AtomicRoboticsX/Only/t-photos/Divertida.png

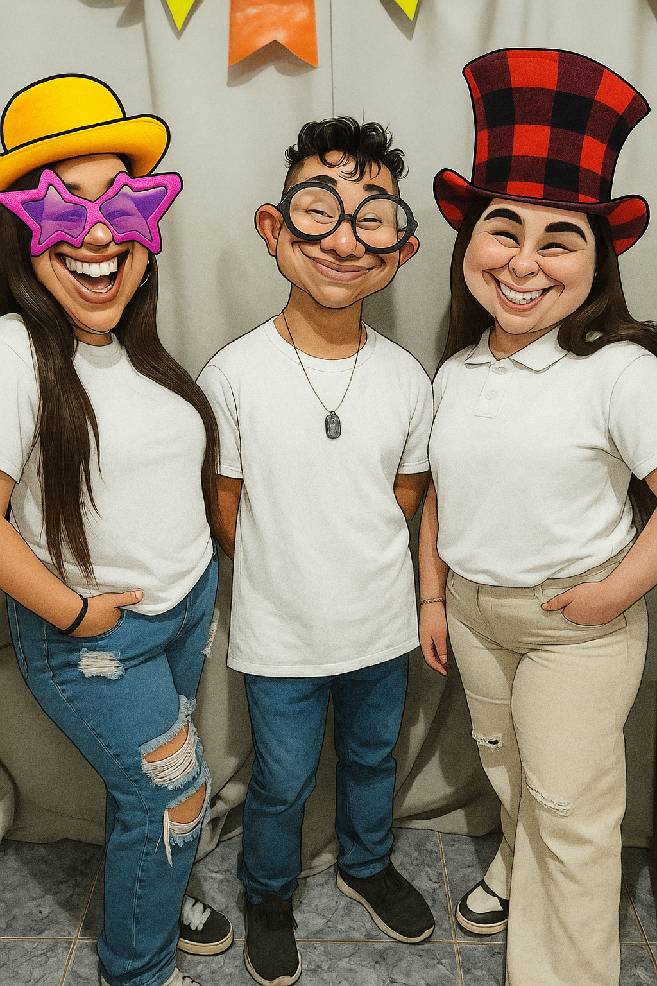
t-photos/Divertida.png
