AtomicRoboticsX/Only/schemes/CIRCUITO.png

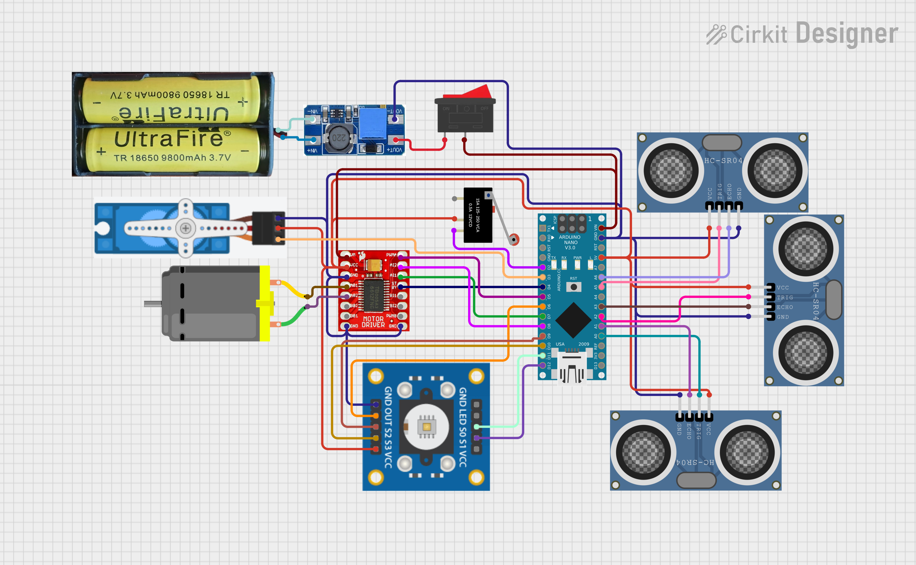
schemes/CIRCUITO.png
