AtomicRoboticsX/Only/video/video.md

/_video de prueba n°1_/
https://youtube.com/shorts/ghTwBgEqhd0?feature=share

/_video de prueba n°2_/
https://youtube.com/shorts/INSqkasOESc?feature=share
