AtomicRoboticsX/Only/t-photos/Oficial.jpeg

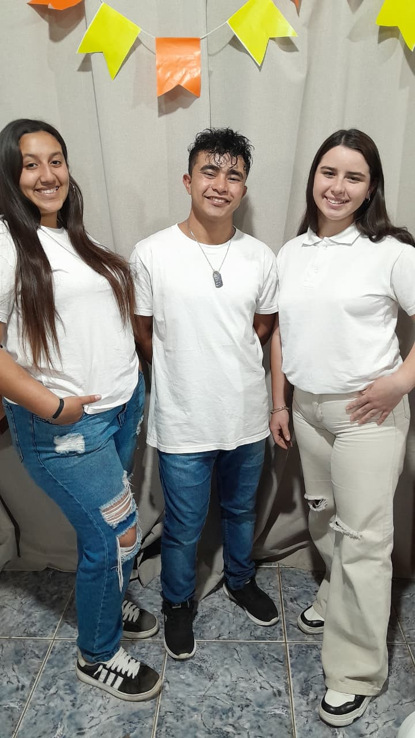
t-photos/Oficial.jpeg
