AtomicRoboticsX/Only/v-photos/ONLY (1).jpeg

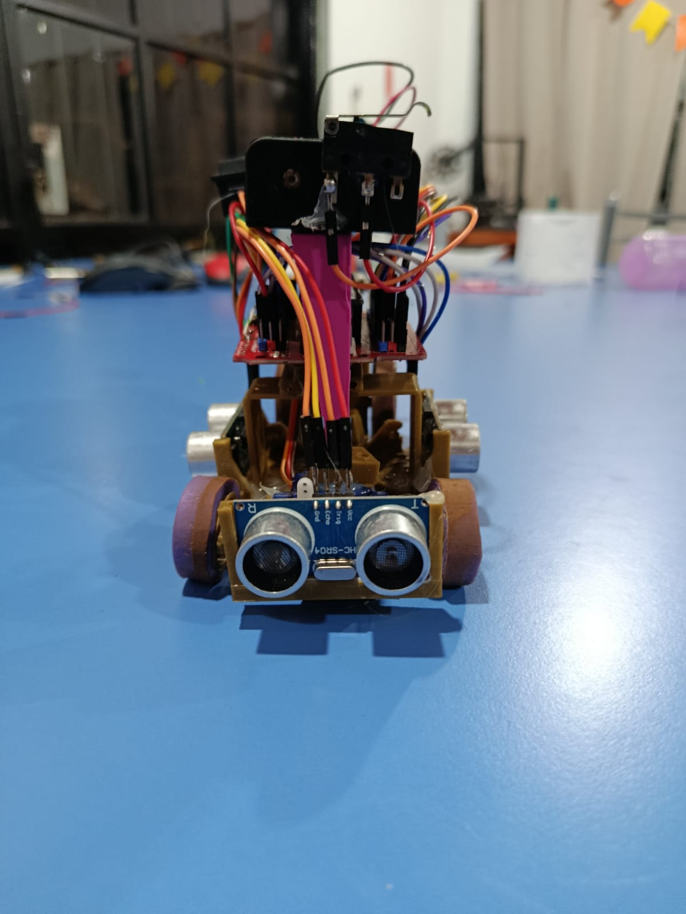
v-photos/ONLY (1).jpeg
