AtomicRoboticsX/Only/v-photos/ONLY (2).jpeg

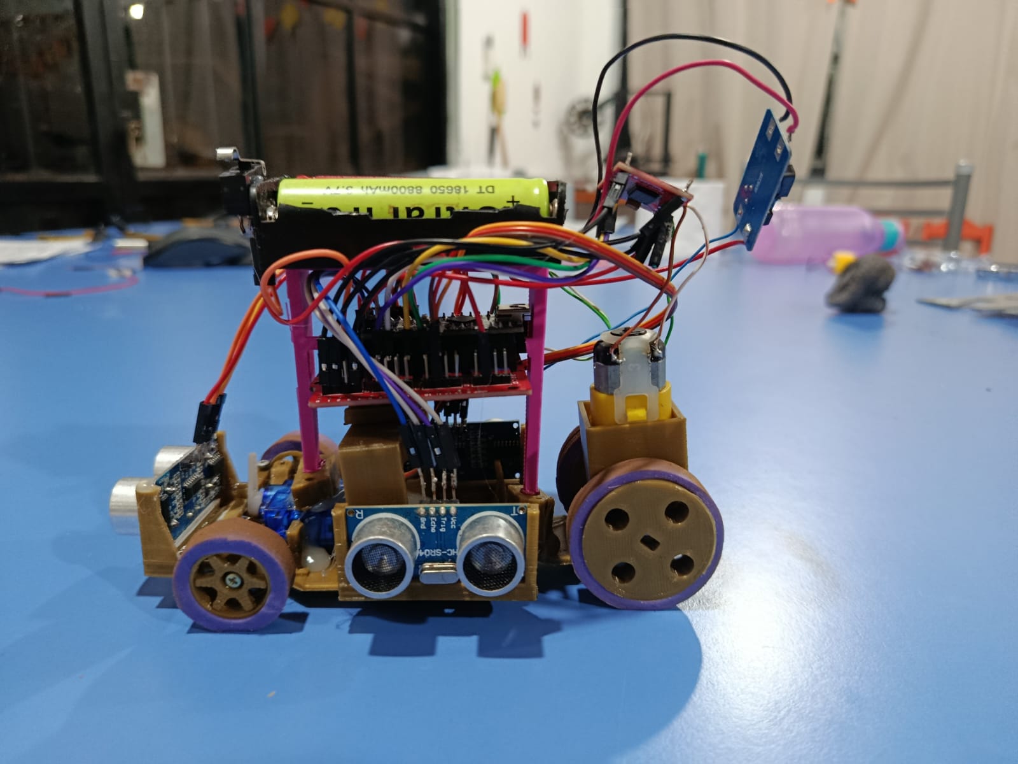
v-photos/ONLY (2).jpeg
