AtomicRoboticsX/Only/v-photos/ONLY (3).jpeg

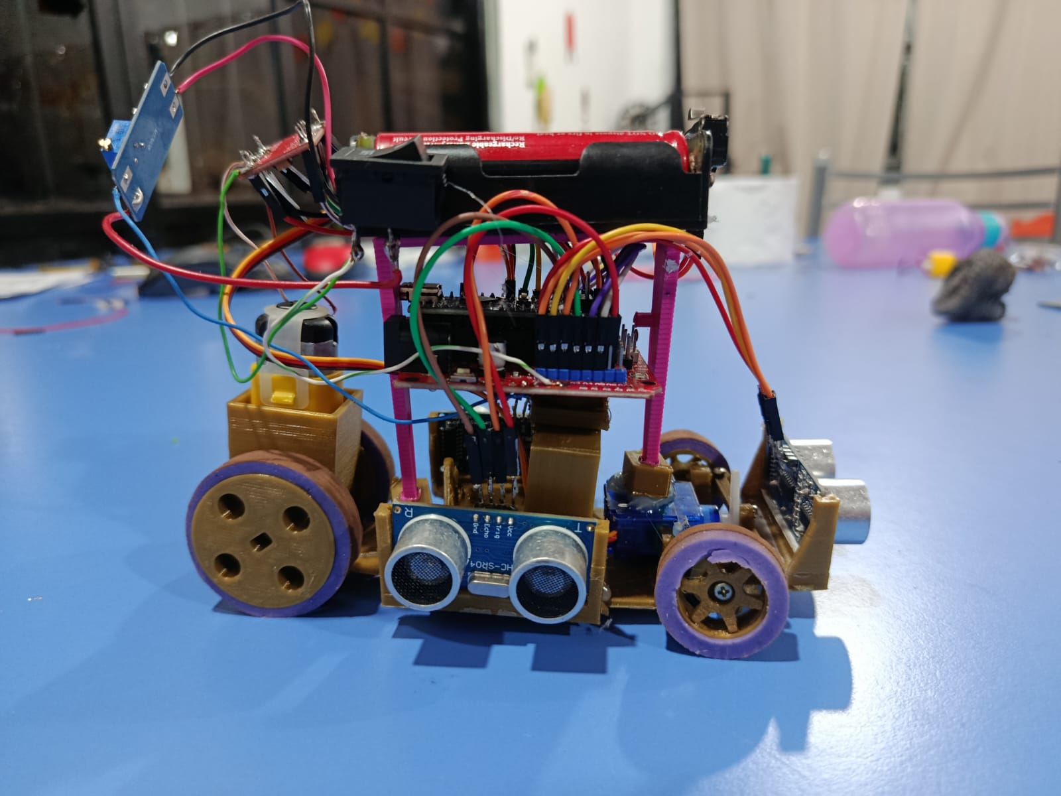
v-photos/ONLY (3).jpeg
