AtomicRoboticsX/Only/v-photos/ONLY (4).jpeg

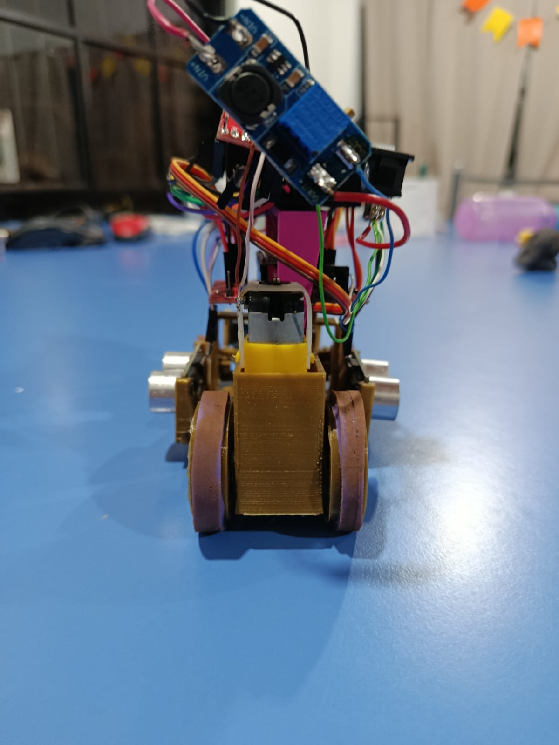
v-photos/ONLY (4).jpeg
