AtomicRoboticsX/Only/v-photos/ONLY (5).jpeg

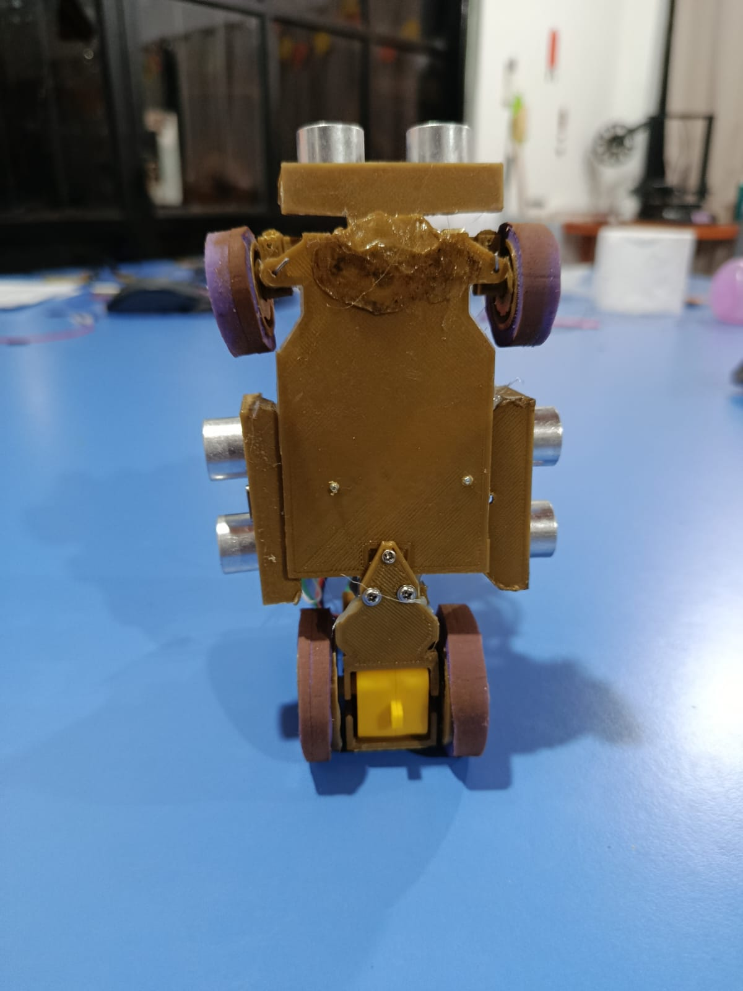
v-photos/ONLY (5).jpeg
