AtomicRoboticsX/Only/v-photos/ONLY (6).jpeg

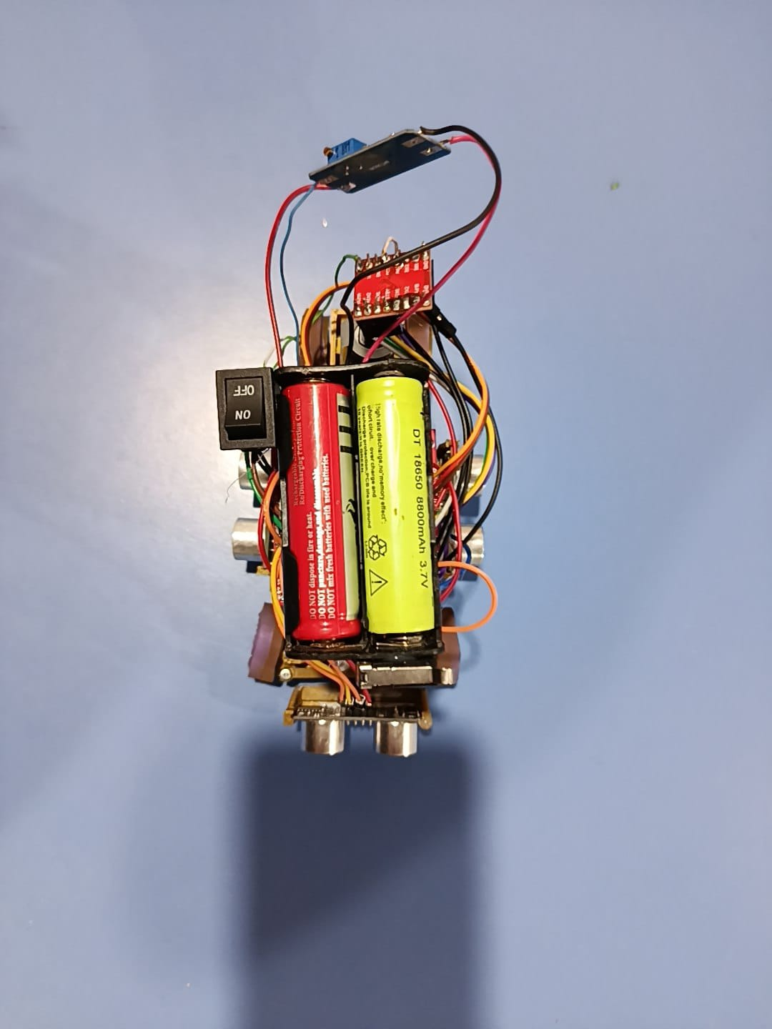
v-photos/ONLY (6).jpeg
