AtomicRoboticsX/Only/v-photos/P1 (1).jpeg

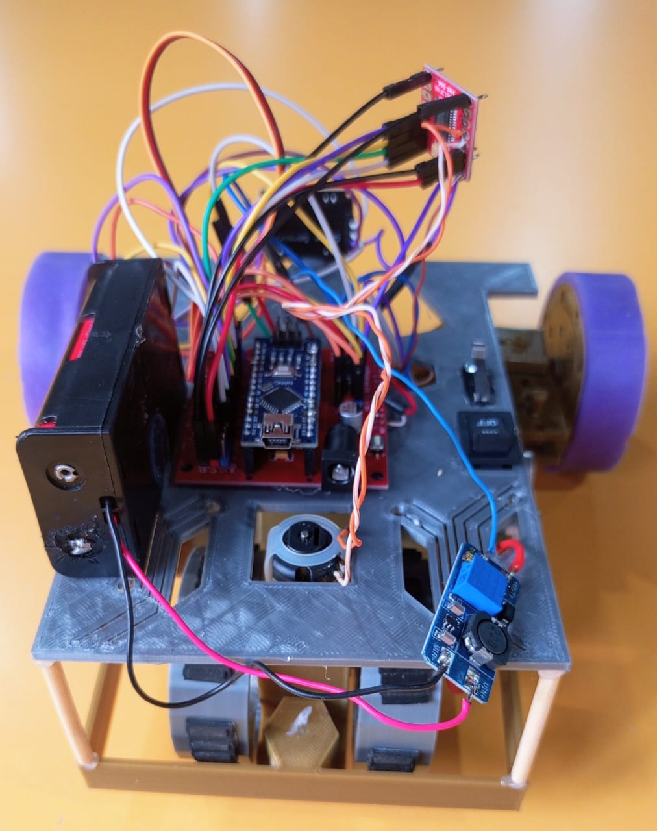
v-photos/P1 (1).jpeg
