AtomicRoboticsX/Only/v-photos/P1 (2).jpeg

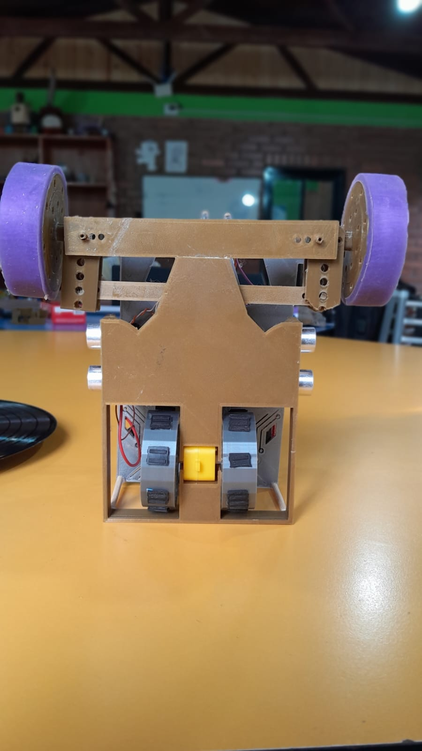
v-photos/P1 (2).jpeg
