AtomicRoboticsX/Only/v-photos/P1 (3).jpeg

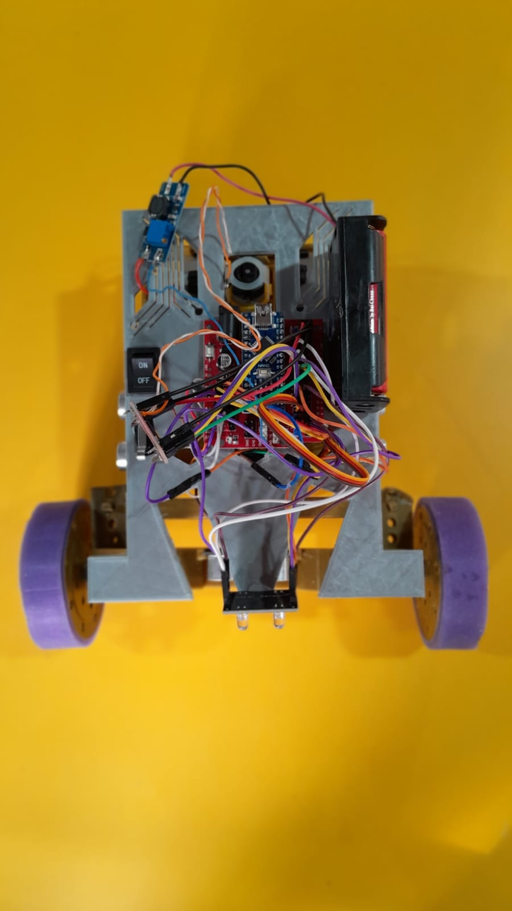
v-photos/P1 (3).jpeg
