AtomicRoboticsX/Only/v-photos/P1 (4).jpeg

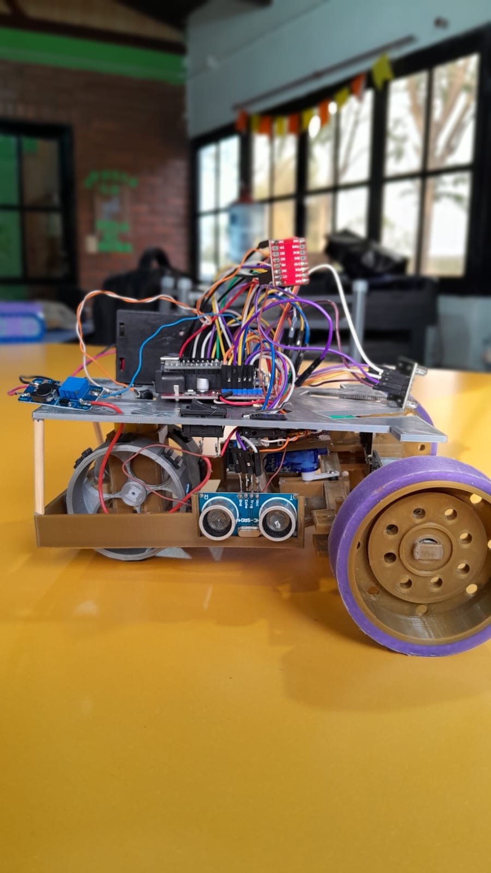
v-photos/P1 (4).jpeg
