AtomicRoboticsX/Only/v-photos/P1 (5).jpeg

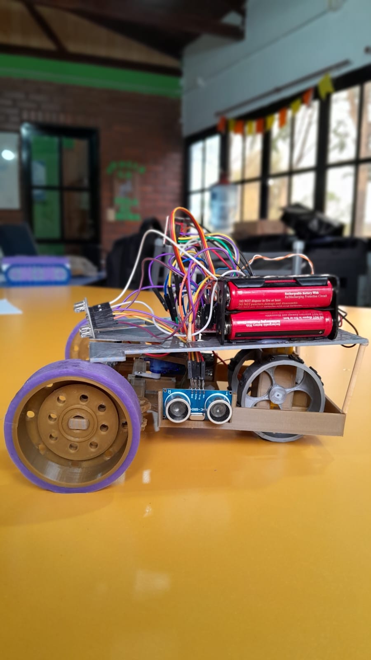
v-photos/P1 (5).jpeg
