AtomicRoboticsX/Only/v-photos/P1 (6).jpeg

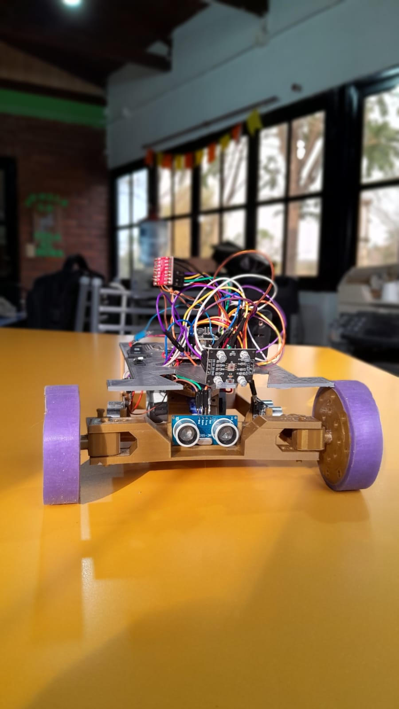
v-photos/P1 (6).jpeg
