AtomicRoboticsX/Only/models/Only-R-Trasera.stl

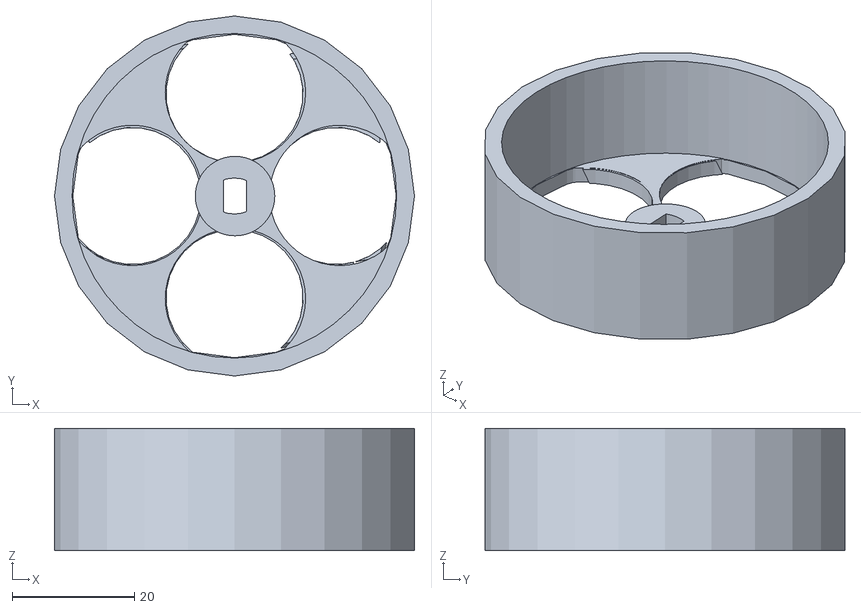
[picture p16: CAD file, 2025-09-04]
models/Only-R-Trasera.stl
59.0 x 59.0 x 20.0
