AtomicRoboticsX/Only/models/Only-cremallera.stl

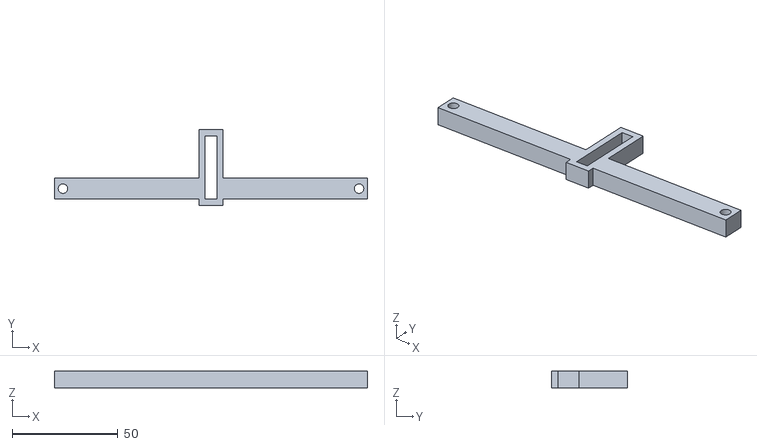
[picture p17: CAD file, 2025-09-04]
models/Only-cremallera.stl
148.0 x 36.0 x 8.00
