AtomicRoboticsX/Only/models/Only-Sop-Tapa-2.stl

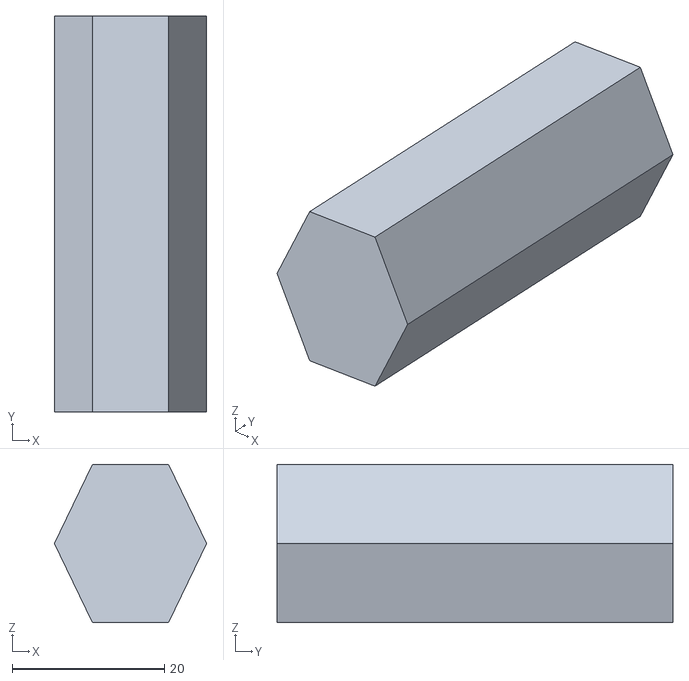
[picture p18: CAD file, 2025-09-04]
models/Only-Sop-Tapa-2.stl
20.0 x 52.0 x 20.8
