AtomicRoboticsX/Only/models/Only-Tapa.stl

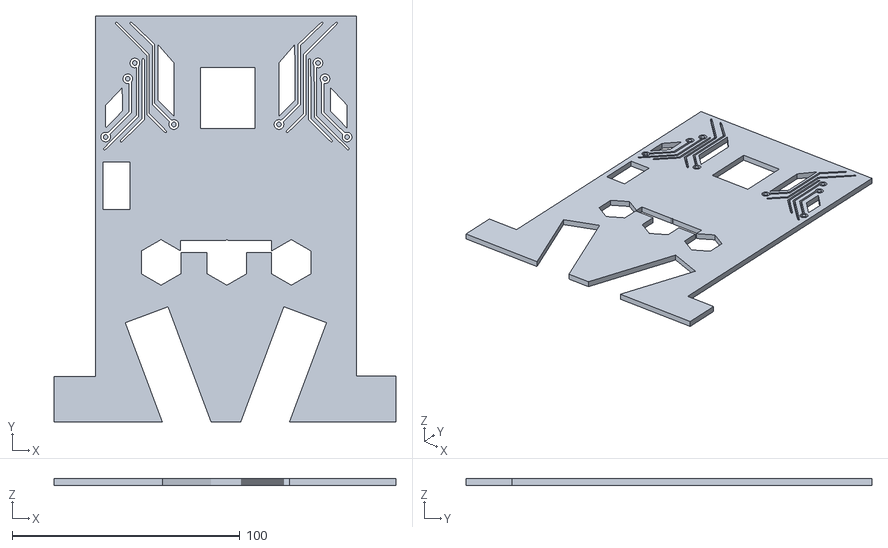
[picture p19: CAD file, 2025-09-04]
models/Only-Tapa.stl
150.0 x 178.0 x 3.00
