AtomicRoboticsX/Only/models/Only-S-Servo.stl

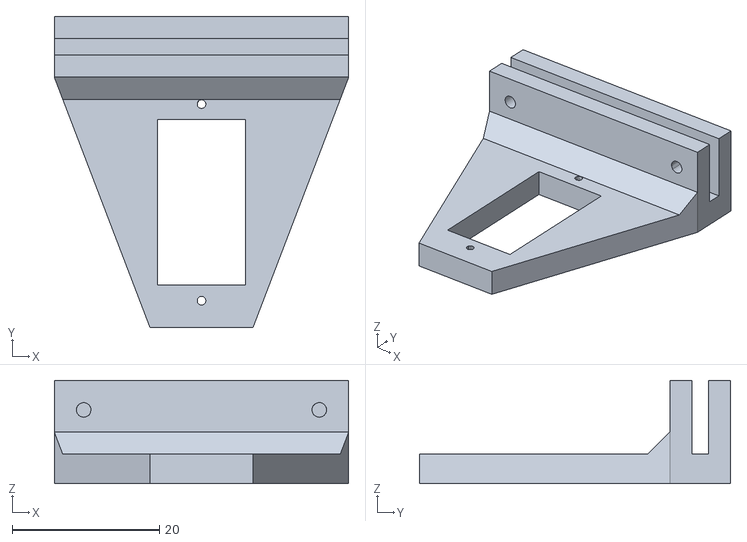
[picture p20: CAD file, 2025-09-04]
models/Only-S-Servo.stl
40.0 x 42.2 x 14.0
