AtomicRoboticsX/Only/models/Only-Seguro-rueda.stl

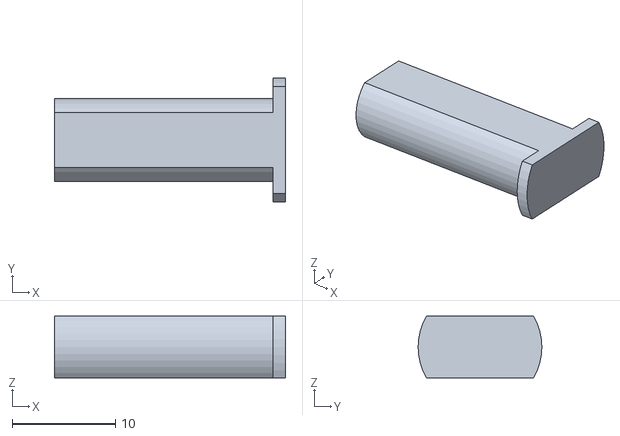
[picture p21: CAD file, 2025-09-04]
models/Only-Seguro-rueda.stl
22.4 x 12.0 x 6.00
