AtomicRoboticsX/Only/models/Only-Rueda.stl

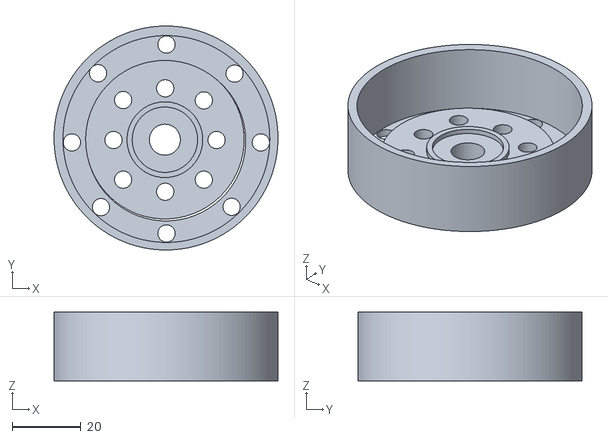
[picture p22: CAD file, 2025-09-04]
models/Only-Rueda.stl
65.0 x 65.0 x 20.0
