AtomicRoboticsX/Only/models/Only-S-Rueda.stl

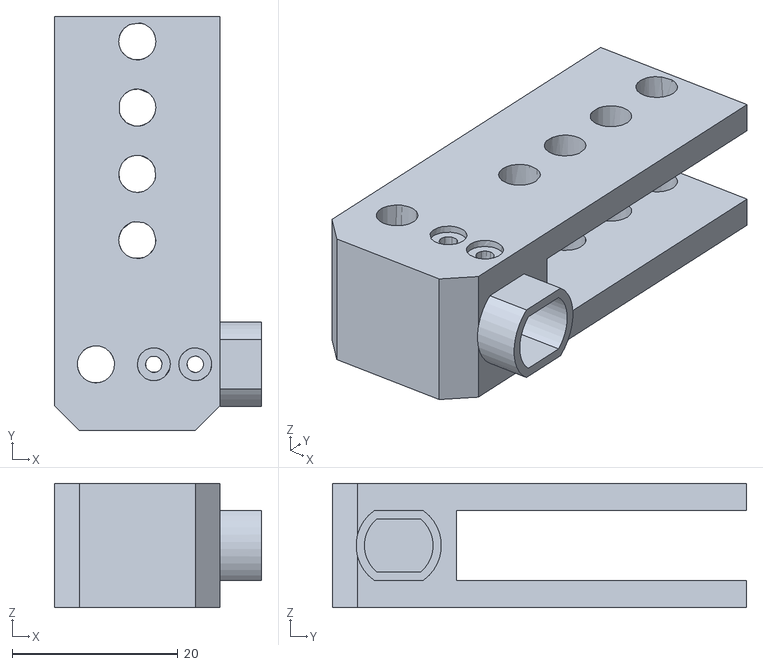
[picture p23: CAD file, 2025-09-04]
models/Only-S-Rueda.stl
25.0 x 50.0 x 15.0
