AtomicRoboticsX/Only/models/Only-Chasis.stl

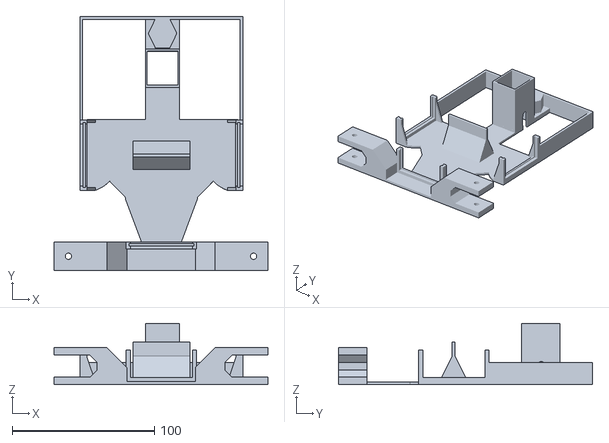
[picture p24: CAD file, 2025-09-04]
models/Only-Chasis.stl
150.0 x 178.4 x 43.1
