AtomicRoboticsX/Only/models/Only-Sop-Tapa.stl

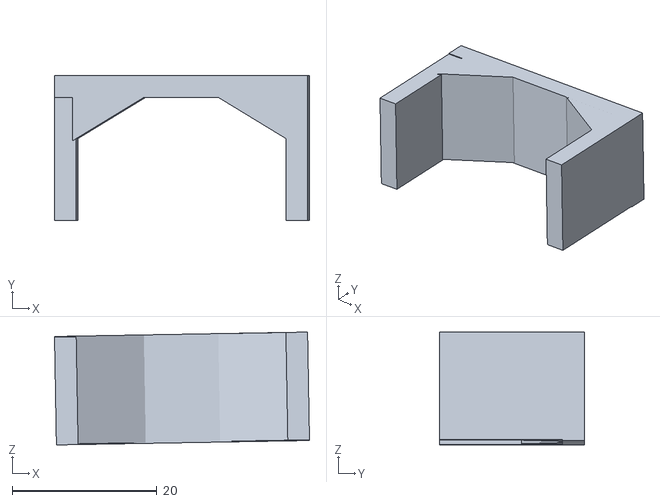
[picture p25: CAD file, 2025-09-04]
models/Only-Sop-Tapa.stl
35.3 x 20.0 x 15.6
