AtomicRoboticsX/Only/models/Only-Sop-Sensor-Luz.stl

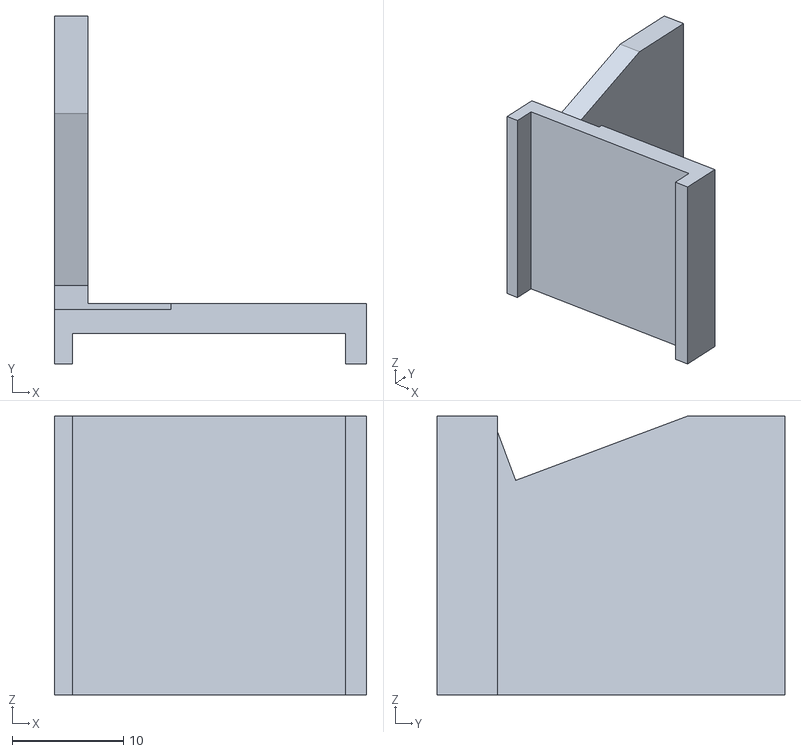
[picture p26: CAD file, 2025-09-04]
models/Only-Sop-Sensor-Luz.stl
28.0 x 31.2 x 25.0
