AtomicRoboticsX/Only/(commit log)

2025-09-04 primera carga
    [Only-Chasis.stl, Only-R-Trasera.stl, Only-Rueda.stl, Only-S-Rueda.stl, Only-S-Servo.stl, Only-Seguro-rueda.stl, Only-Sop-Sensor-Luz.stl, Only-Sop-Tapa-2.stl]
2025-09-04 agregamos la foto divertida
2025-09-04 subimos la nueva versión del código
2025-09-04 se actualiza el código a la versión CODE-3´
